miheych/carisma_pc_mod/Connection circuit/rev3_with_L9637D.jpg

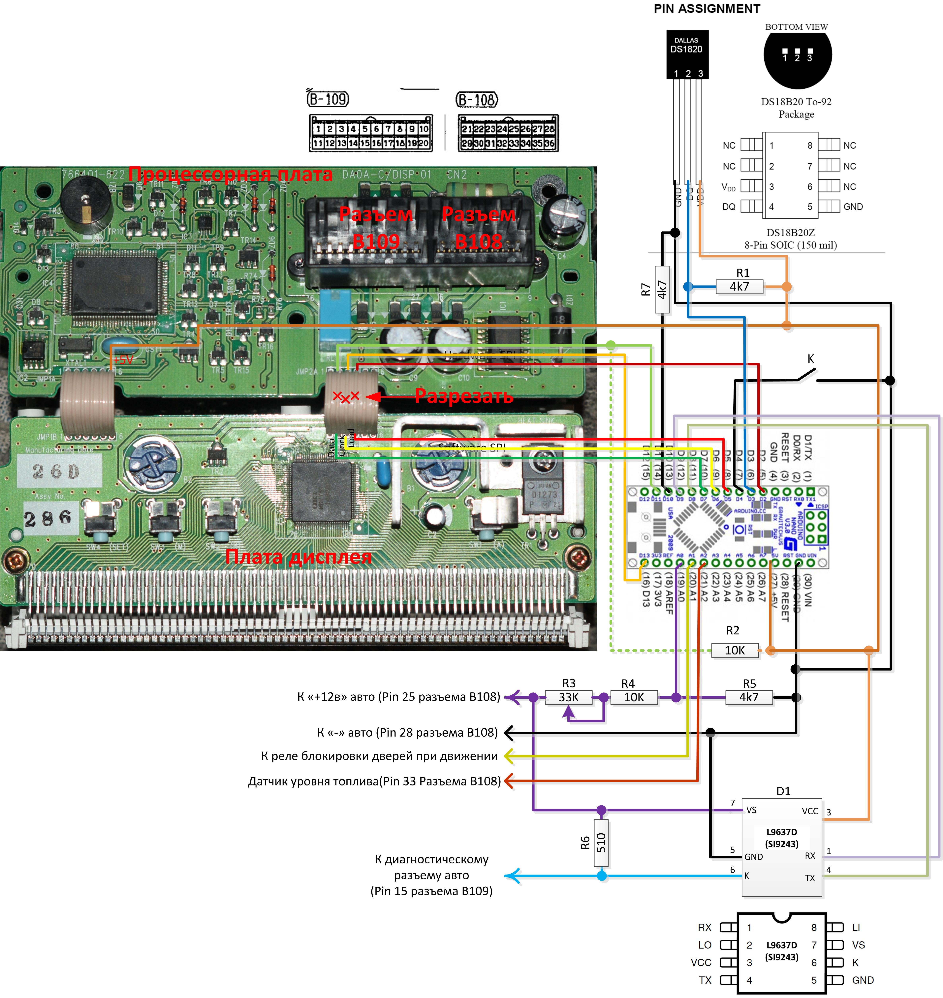
Connection circuit/rev3_with_L9637D.jpg
