miheych/carisma_pc_mod/Pict/finish_view.jpg

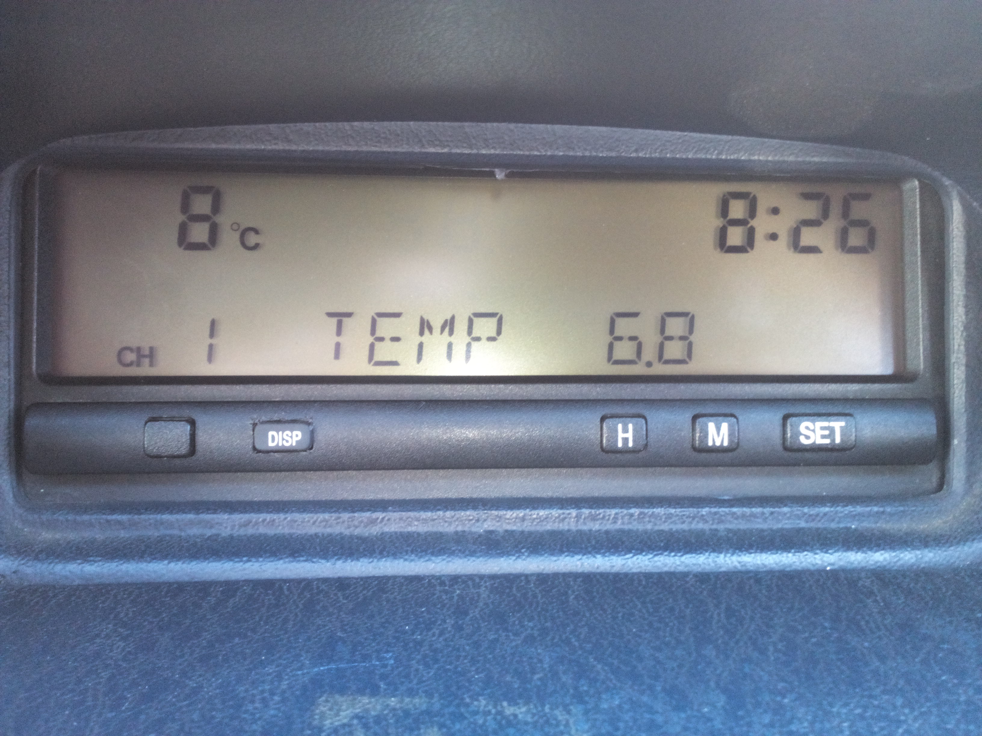
Pict/finish_view.jpg
