miheych/carisma_pc_mod/Pict/XLoader.jpg

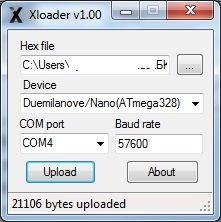
Pict/XLoader.jpg
