miheych/carisma_pc_mod/Pict/Пример тактовой кнопки.jpg

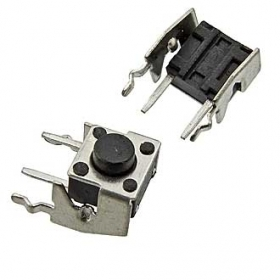
Pict/Пример тактовой кнопки.jpg
