miheych/carisma_pc_mod/Docs/Users manual.md

Описание работы БК.
--------------

После модернизации бортовой компьютер продолжит отображать показания наружной температуры воздуха и времени без изменений. Данная информация поступает с основного процессороа БК и никак не видоизменяется. Настройка времени осуществляется, как обычно, кнопками [Н] [M] и [SET]. В центре верхней строки во время обмена данными по MUT отображается средний расход, рассчитываемый микроконтроллером платы arduino. 

В нижней строке дисплея отображаются различные параметры работы автомобиля. Переключение их осуществляется циклически, нажатием кнопки. На текущий момент реализованы режимы с 0 по 9, однако не исключено, что могут быть добавлены новые.

В правом нижнем углу в виде динамической полоски отображается текущая нагрузка на двигатель. Данный параметр считывается с ECU автомобиля, но нужно отметить, что данные показания носят лишь ориентировочный характер.

Описание режимов:

0. Ничего не отображает. Если зажать кнопку переключения режимов более 3 сек. полностью выключается диагностика по MUT. Может потребоваться чтобы подключиться к машине обычным диагностическим адаптером, так как при работе БК в режиме обмена данными по MUT, внешним адаптером подключиться не получится.
1. Температура воздуха внутри салона автомобиля. Данные снимаются с датчика подключенного к плате arduino, поэтому от места его расположения будет зависеть точность показаний.
2. Напряжение бортовой сети. До пуска двигателя имеряется внутренними средствами платы arduino. После пуска двигателя и установления MUT-соединения считывается с ECU автомобиля.
3. Счетчик пробега. Считает пробег от сброса показаний до следующего сброса. Сброс осуществляется зажатием кнопки переключения режимов на время более 3 сек.
4. Суммарный расход топлива в литрах. Считает аналогично предыдущему режиму, от сброса до сброса. Сброс осуществляется зажатием кнопки переключения режимов на время более 3 сек.
5. Мгновенный расход топлива. При зажатии кнопки переключения режимов на время более 3 сек. осуществляется сброс статистики среднего расхода, отображаемого в верхней строке.
6. Температура охлаждающей жидкости в градусах цельсия.
7. Обороты двигателя, об/мин.
8. Долговременная топливная коррекция (LTFT). 
9. Режим чтения ошибок OBD2. (экспериментальная функция, может работать некорректно). Чтобы считать ошибки нужно выбрать данный режим и зажать кнопку переключения режимов на время более 3 сек. Если ошибки есть - они будут отображаться в стандартных кодах, например P0203. Для сброса ошибок, в случае их присутствия, нужно также зажать кнопку переключения режимов на время более 3 сек.

Видео работы доработанного БК:

(http://www.youtube.com/watch?v=gFz78esyOUs)

**Порядок режимов на видео может несколько отличаться от реализованного в прошивке.*

Чтение и сброс ошибок:

(http://www.youtube.com/watch?v=guMvadppkAk)

Также фото и видео готового изделия можно посмотреть в [теме](http://carisma-club.su/index.php?showtopic=2685) на форуме carisma-club.su.
