miheych/carisma_pc_mod/Changelog.txt

12.09.2017, ver 9.23_b017 - First public release.
