miheych/carisma_pc_mod/(commit log)

2017-09-08 Create Инструкция по доработке бортового компьютера Mitsubishi Carisma.md
2017-09-08 Update and rename Инструкция по доработке бортового компьютера Mitsubishi Carisma.md to Инструкция по доработке.md
2017-09-11 Update Инструкция по доработке.md
2017-09-12 Rename Инструкция по доработке.md to Hardware instruction.md
